OLIMEX/RK3328-SOM-EBV/README.md

# RK3328-SOM-EVB
Evaluation board for RK3328-SOM System on modules

Product page: https://www.olimex.com/Products/SOM/RK3328/RK3328-EVB/

## License
* Hardware is released under CERN OHL v1.2 license
* Software is released under GPL3 License
* Documentation is released under CC BY-SA 3.0
