OLIMEX/RK3328-SOM-EBV/HARDWARE/RK3328-SOM-EVB_Rev-A/3d/TFC-WPAPR-08---112J-TXAR-R_C_1-1.STEP

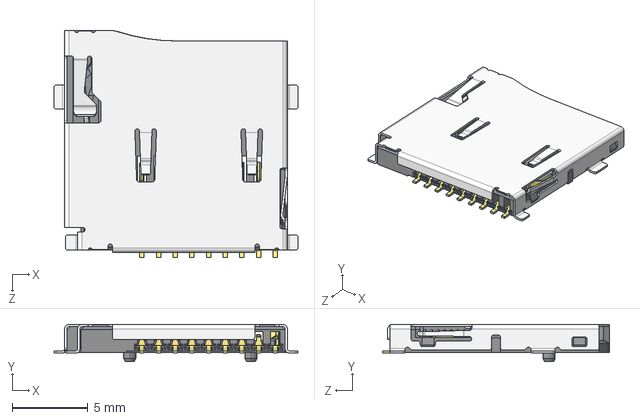
[picture p6: CAD file, 2021-05-31]
HARDWARE/RK3328-SOM-EVB_Rev-A/3d/TFC-WPAPR-08---112J-TXAR-R_C_1-1.STEP
16.1 x 2.45 x 15.0 mm
