OLIMEX/RK3328-SOM-EBV/HARDWARE/RK3328-SOM-EVB_Rev-A/3d/BH26S---CH8726xVA00.STEP

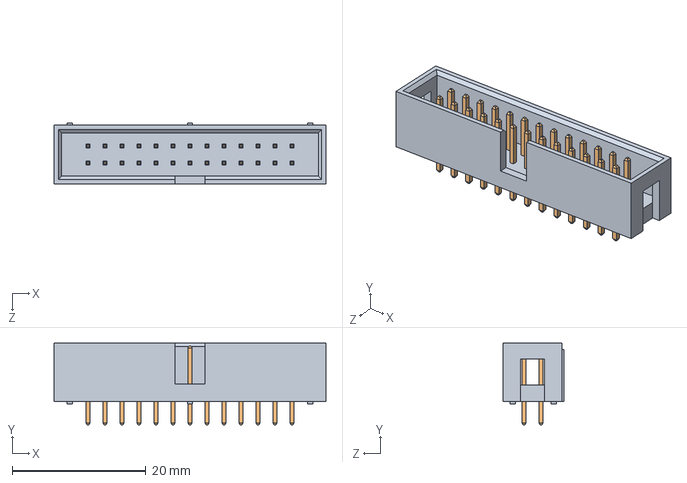
[picture p7: CAD file, 2021-05-31]
HARDWARE/RK3328-SOM-EVB_Rev-A/3d/BH26S---CH8726xVA00.STEP
40.6 x 12.2 x 9.10 mm
CH87 BASE_26
CH87 V PIN x 26
