OLIMEX/RK3328-SOM-EBV/HARDWARE/RK3328-SOM-EVB_Rev-A/3d/USB-A-S-F-B-VU.stp

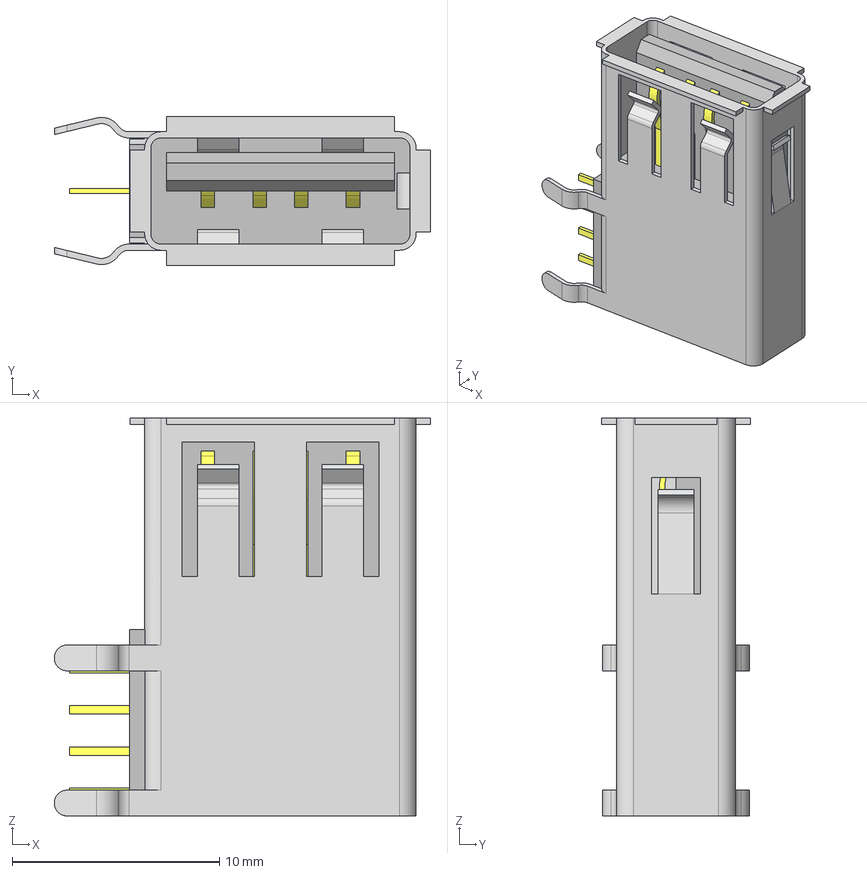
[picture p8: CAD file, 2021-05-31]
HARDWARE/RK3328-SOM-EVB_Rev-A/3d/USB-A-S-F-B-VU.stp
18.2 x 7.20 x 19.2 mm
_USB-A-S-VU_S
_USB-A-S-B-VU_B
_USB-A-S-VU_P
