OLIMEX/RK3328-SOM-EBV/HARDWARE/RK3328-SOM-EVB_Rev-A/3d/40PinMaleSMD.stp

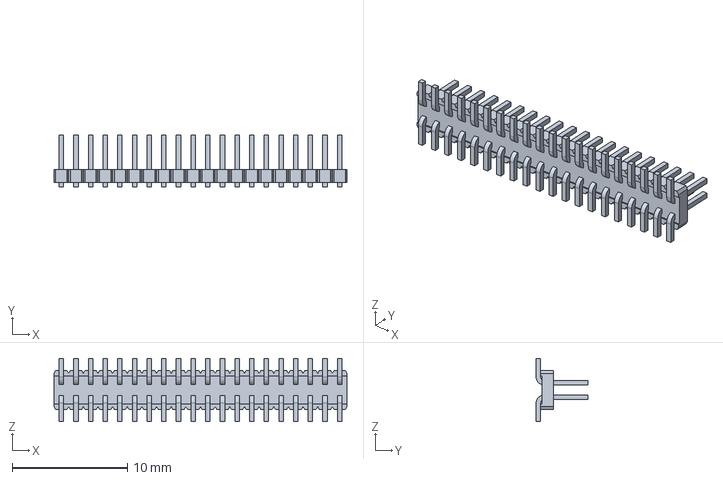
[picture p9: CAD file, 2021-05-31]
HARDWARE/RK3328-SOM-EVB_Rev-A/3d/40PinMaleSMD.stp
25.4 x 4.50 x 5.50 mm
