OLIMEX/RK3328-SOM-EBV/HARDWARE/RK3328-SOM-EVB_Rev-A/3d/pj-102ah.stp

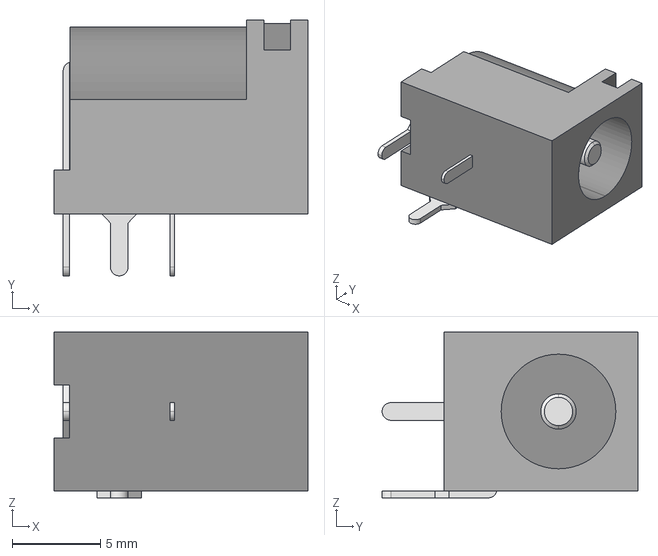
[picture p10: CAD file, 2021-05-31]
HARDWARE/RK3328-SOM-EVB_Rev-A/3d/pj-102ah.stp
14.4 x 14.5 x 9.40 mm
