OLIMEX/RK3328-SOM-EBV/HARDWARE/RK3328-SOM-EVB_Rev-A/3d/DO-214AA_SMB.step

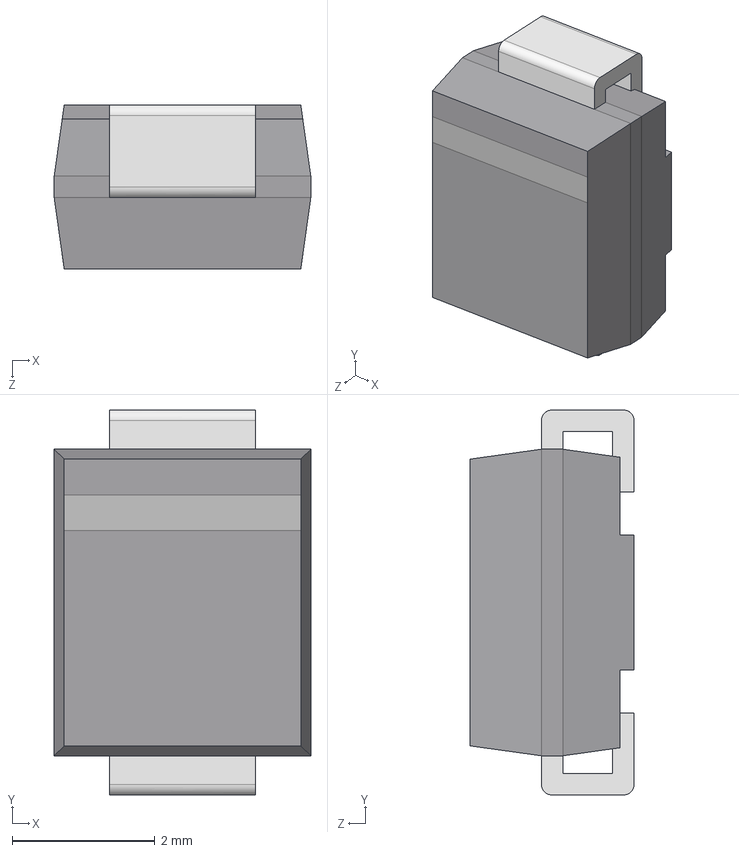
[picture p11: CAD file, 2021-05-31]
HARDWARE/RK3328-SOM-EVB_Rev-A/3d/DO-214AA_SMB.step
3.60 x 5.40 x 2.30 mm
