OLIMEX/RK3328-SOM-EBV/HARDWARE/RK3328-SOM-EVB_Rev-A/3d/HN1x3-PinHeader_1x03_P2.54mm_Vertical.step

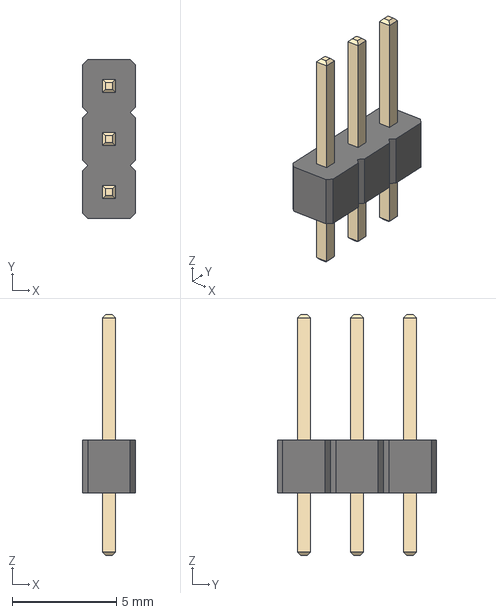
[picture p12: CAD file, 2021-05-31]
HARDWARE/RK3328-SOM-EVB_Rev-A/3d/HN1x3-PinHeader_1x03_P2.54mm_Vertical.step
2.54 x 7.62 x 11.5 mm
