OLIMEX/RK3328-SOM-EBV/HARDWARE/RK3328-SOM-EVB_Rev-A/3d/Connector_1Port_RJ45_Magjack_10-100Base-T_AutoMDIX_Wurth_Electronics-7499010441.stp

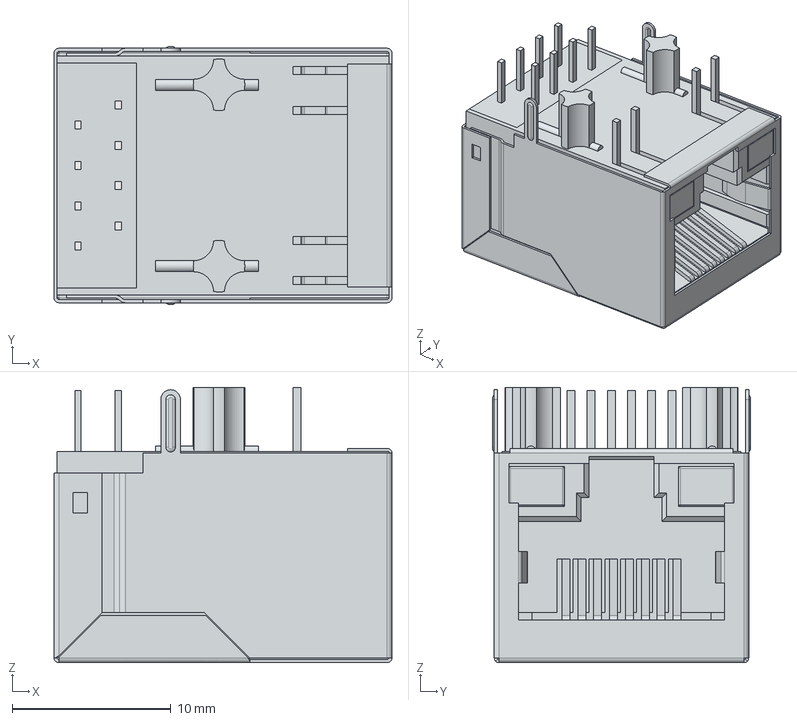
[picture p14: CAD file, 2021-05-31]
HARDWARE/RK3328-SOM-EVB_Rev-A/3d/Connector_1Port_RJ45_Magjack_10-100Base-T_AutoMDIX_Wurth_Electronics-7499010441.stp
21.3 x 16.2 x 17.4 mm
Shielding
Insulator 3
Insulator 1
Insulator 2
Green_Yellow_LED x 2
