OLIMEX/RK3328-SOM-EBV/HARDWARE/RK3328-SOM-EVB_Rev-A/3d/usb_micro_4p.stp

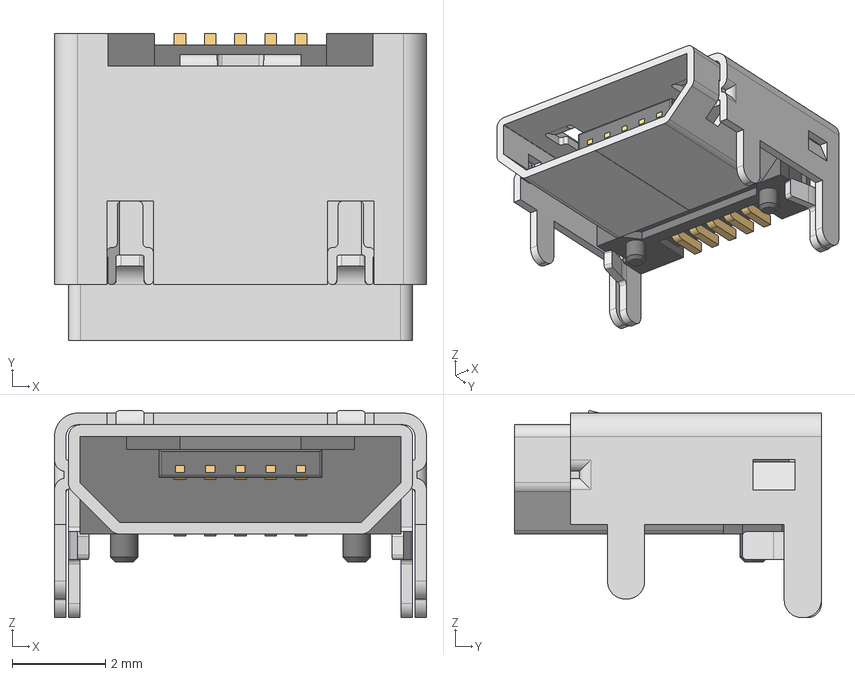
[picture p15: CAD file, 2021-05-31]
HARDWARE/RK3328-SOM-EVB_Rev-A/3d/usb_micro_4p.stp
8.00 x 6.60 x 4.46 mm
