OLIMEX/RK3328-SOM-EBV/HARDWARE/RK3328-SOM-EVB_Rev-A/3d/BH-10__64.step

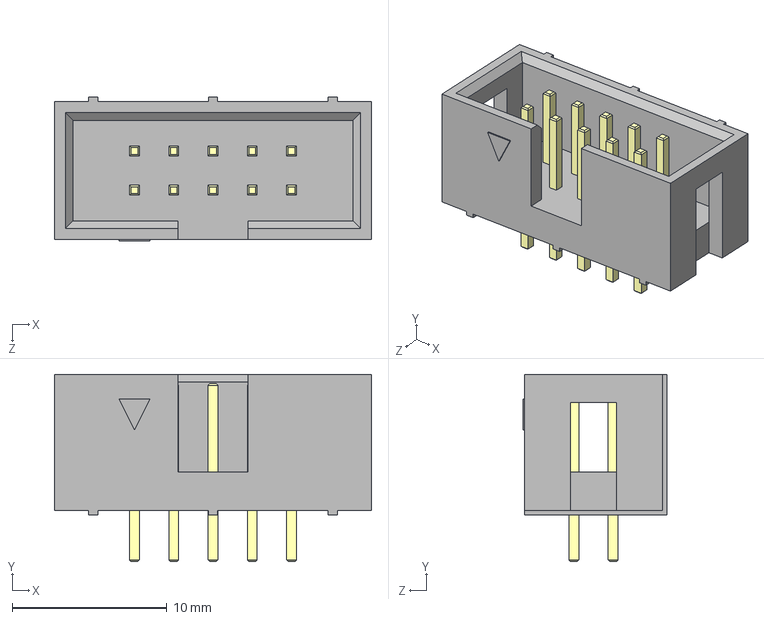
[picture p16: CAD file, 2021-05-31]
HARDWARE/RK3328-SOM-EVB_Rev-A/3d/BH-10__64.step
20.5 x 12.1 x 9.30 mm
