OLIMEX/RK3328-SOM-EBV/HARDWARE/RK3328-SOM-EVB_Rev-A/3d/SOT-23-5.step

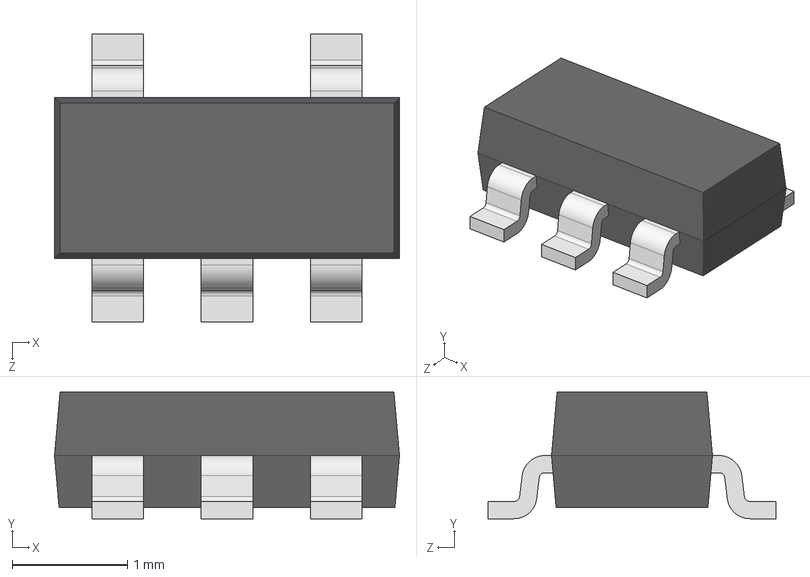
[picture p17: CAD file, 2021-05-31]
HARDWARE/RK3328-SOM-EVB_Rev-A/3d/SOT-23-5.step
3.00 x 1.10 x 2.50 mm
