OLIMEX/RK3328-SOM-EBV/HARDWARE/RK3328-SOM-EVB_Rev-A/3d/SOT-223-2.STEP

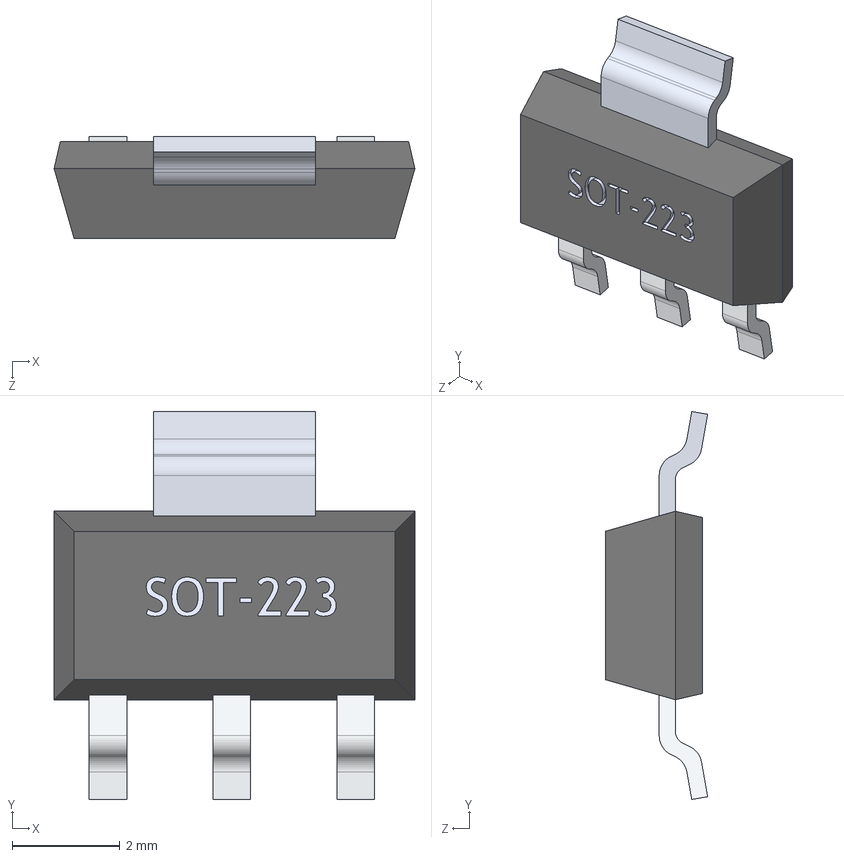
[picture p18: CAD file, 2021-05-31]
HARDWARE/RK3328-SOM-EVB_Rev-A/3d/SOT-223-2.STEP
6.70 x 7.20 x 1.90 mm
User Library-SOT-223-2_PIN_SOT-223_2_1 x 3
User Library-SOT-223-2_SOT-223_1
User Library-SOT-223-2_PIN_SOT-223_1
