OLIMEX/RK3328-SOM-EBV/HARDWARE/RK3328-SOM-EVB_Rev-A/3d/20PinMaleSmt.stp

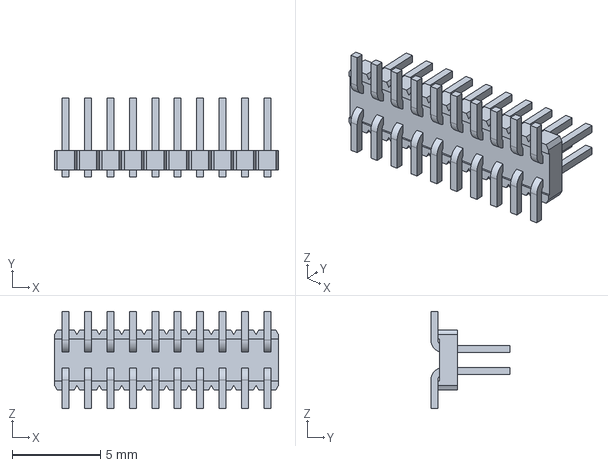
[picture p19: CAD file, 2021-05-31]
HARDWARE/RK3328-SOM-EVB_Rev-A/3d/20PinMaleSmt.stp
12.7 x 4.50 x 5.50 mm
