OLIMEX/RK3328-SOM-EBV/HARDWARE/RK3328-SOM-EVB_Rev-A/3d/USB3.0-TypeA_SWZ1BL-9A.stp

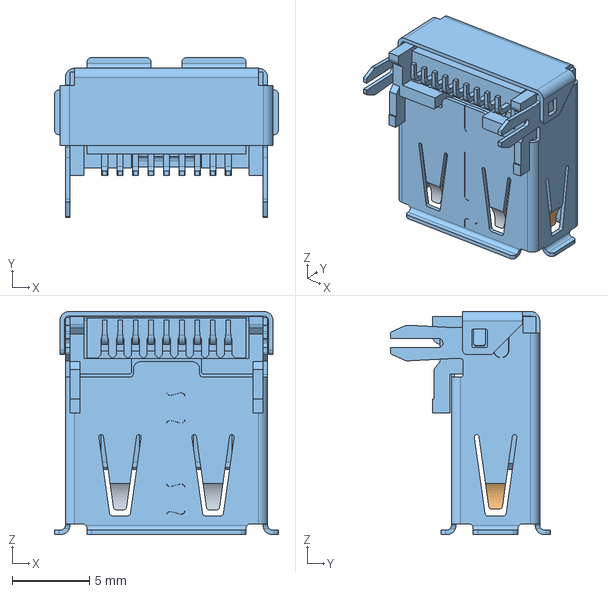
[picture p20: CAD file, 2021-05-31]
HARDWARE/RK3328-SOM-EVB_Rev-A/3d/USB3.0-TypeA_SWZ1BL-9A.stp
14.5 x 10.3 x 14.4 mm
