OLIMEX/RK3328-SOM-EBV/HARDWARE/RK3328-SOM-EVB_Rev-A/3d/QFN48-0.5.STEP

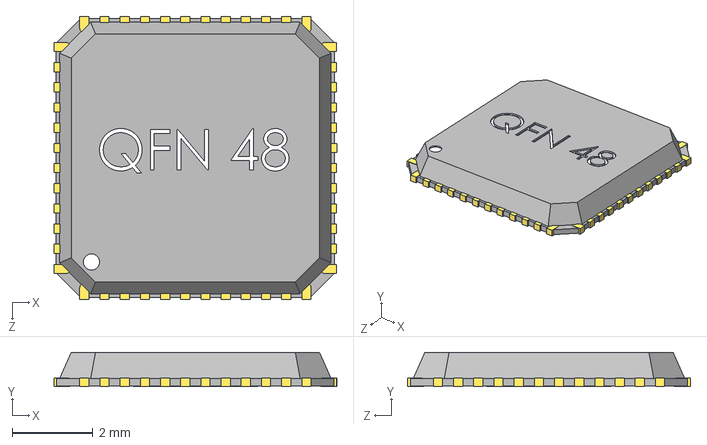
[picture p22: CAD file, 2021-05-31]
HARDWARE/RK3328-SOM-EVB_Rev-A/3d/QFN48-0.5.STEP
7.00 x 0.85 x 7.01 mm
User Library-QFN48-1_Body
User Library-QFN48-1_Pins
