OLIMEX/RK3328-SOM-EBV/HARDWARE/RK3328-SOM-EVB_Rev-A/3d/DO-214AC_SMA.step

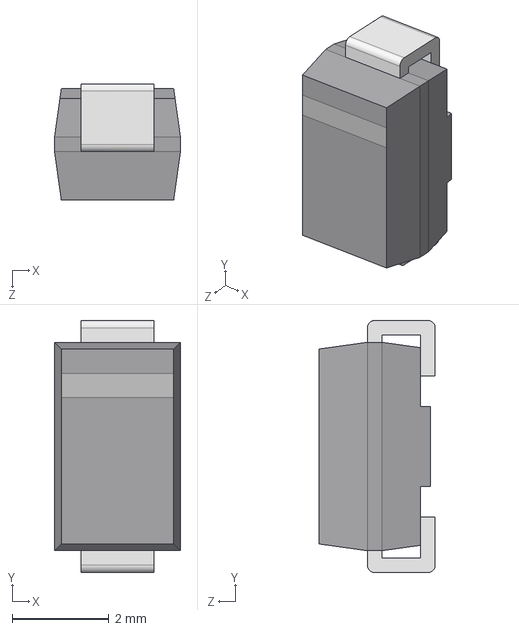
[picture p23: CAD file, 2021-05-31]
HARDWARE/RK3328-SOM-EVB_Rev-A/3d/DO-214AC_SMA.step
2.60 x 5.20 x 2.40 mm
