OLIMEX/RK3328-SOM-EBV/HARDWARE/RK3328-SOM-EVB_Rev-A/3d/SMD075F.step

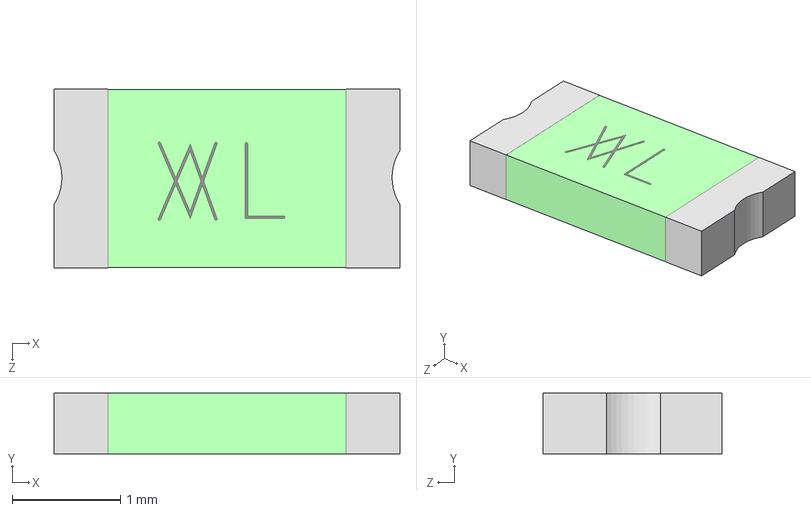
[picture p24: CAD file, 2021-05-31]
HARDWARE/RK3328-SOM-EVB_Rev-A/3d/SMD075F.step
3.20 x 0.562 x 1.65 mm
