OLIMEX/RK3328-SOM-EBV/HARDWARE/RK3328-SOM-EVB_Rev-A/3d/HDMI_19POS_SMD_Wurth_Electronic-685119134923.stp

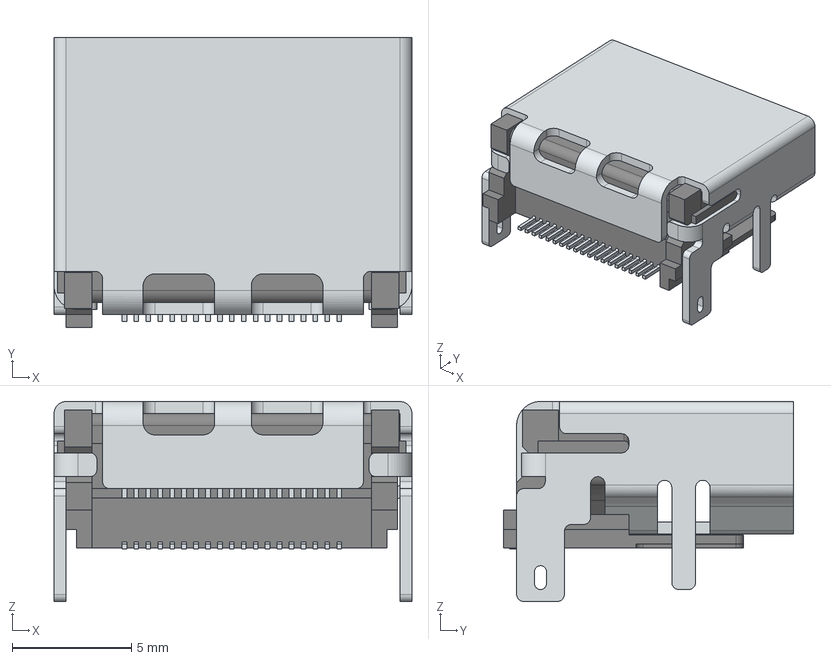
[picture p25: CAD file, 2021-05-31]
HARDWARE/RK3328-SOM-EVB_Rev-A/3d/HDMI_19POS_SMD_Wurth_Electronic-685119134923.stp
15.0 x 12.2 x 8.38 mm
