OLIMEX/RK3328-SOM-EBV/HARDWARE/RK3328-SOM-EVB_Rev-A/3d/DF12(3.0)-40DS-0.5V.stp

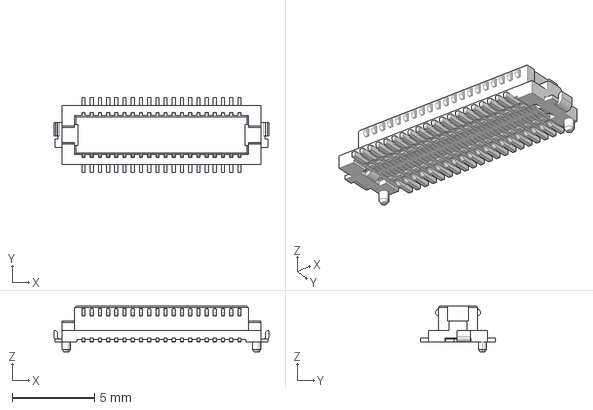
[picture p27: CAD file, 2021-05-31]
HARDWARE/RK3328-SOM-EVB_Rev-A/3d/DF12(3.0)-40DS-0.5V.stp
13.1 x 4.60 x 2.80 mm
