OLIMEX/RK3328-SOM-EBV/(list of files, cad)

Other CAD files:
HARDWARE/RK3328-SOM-EVB_Rev-A/3d/434121043836 (rev1).stp
HARDWARE/RK3328-SOM-EVB_Rev-A/3d/Connector_1Port_RJ45_Magjack_10-100Base-T_AutoMDIX_Molex-0934635206_DigiKey-WM17614-ND.stp
