OLIMEX/RK3328-SOM-EBV/HARDWARE/RK3328-SOM-EVB_Rev-A/RK3328-SOM-EVB_Rev_A.pdf

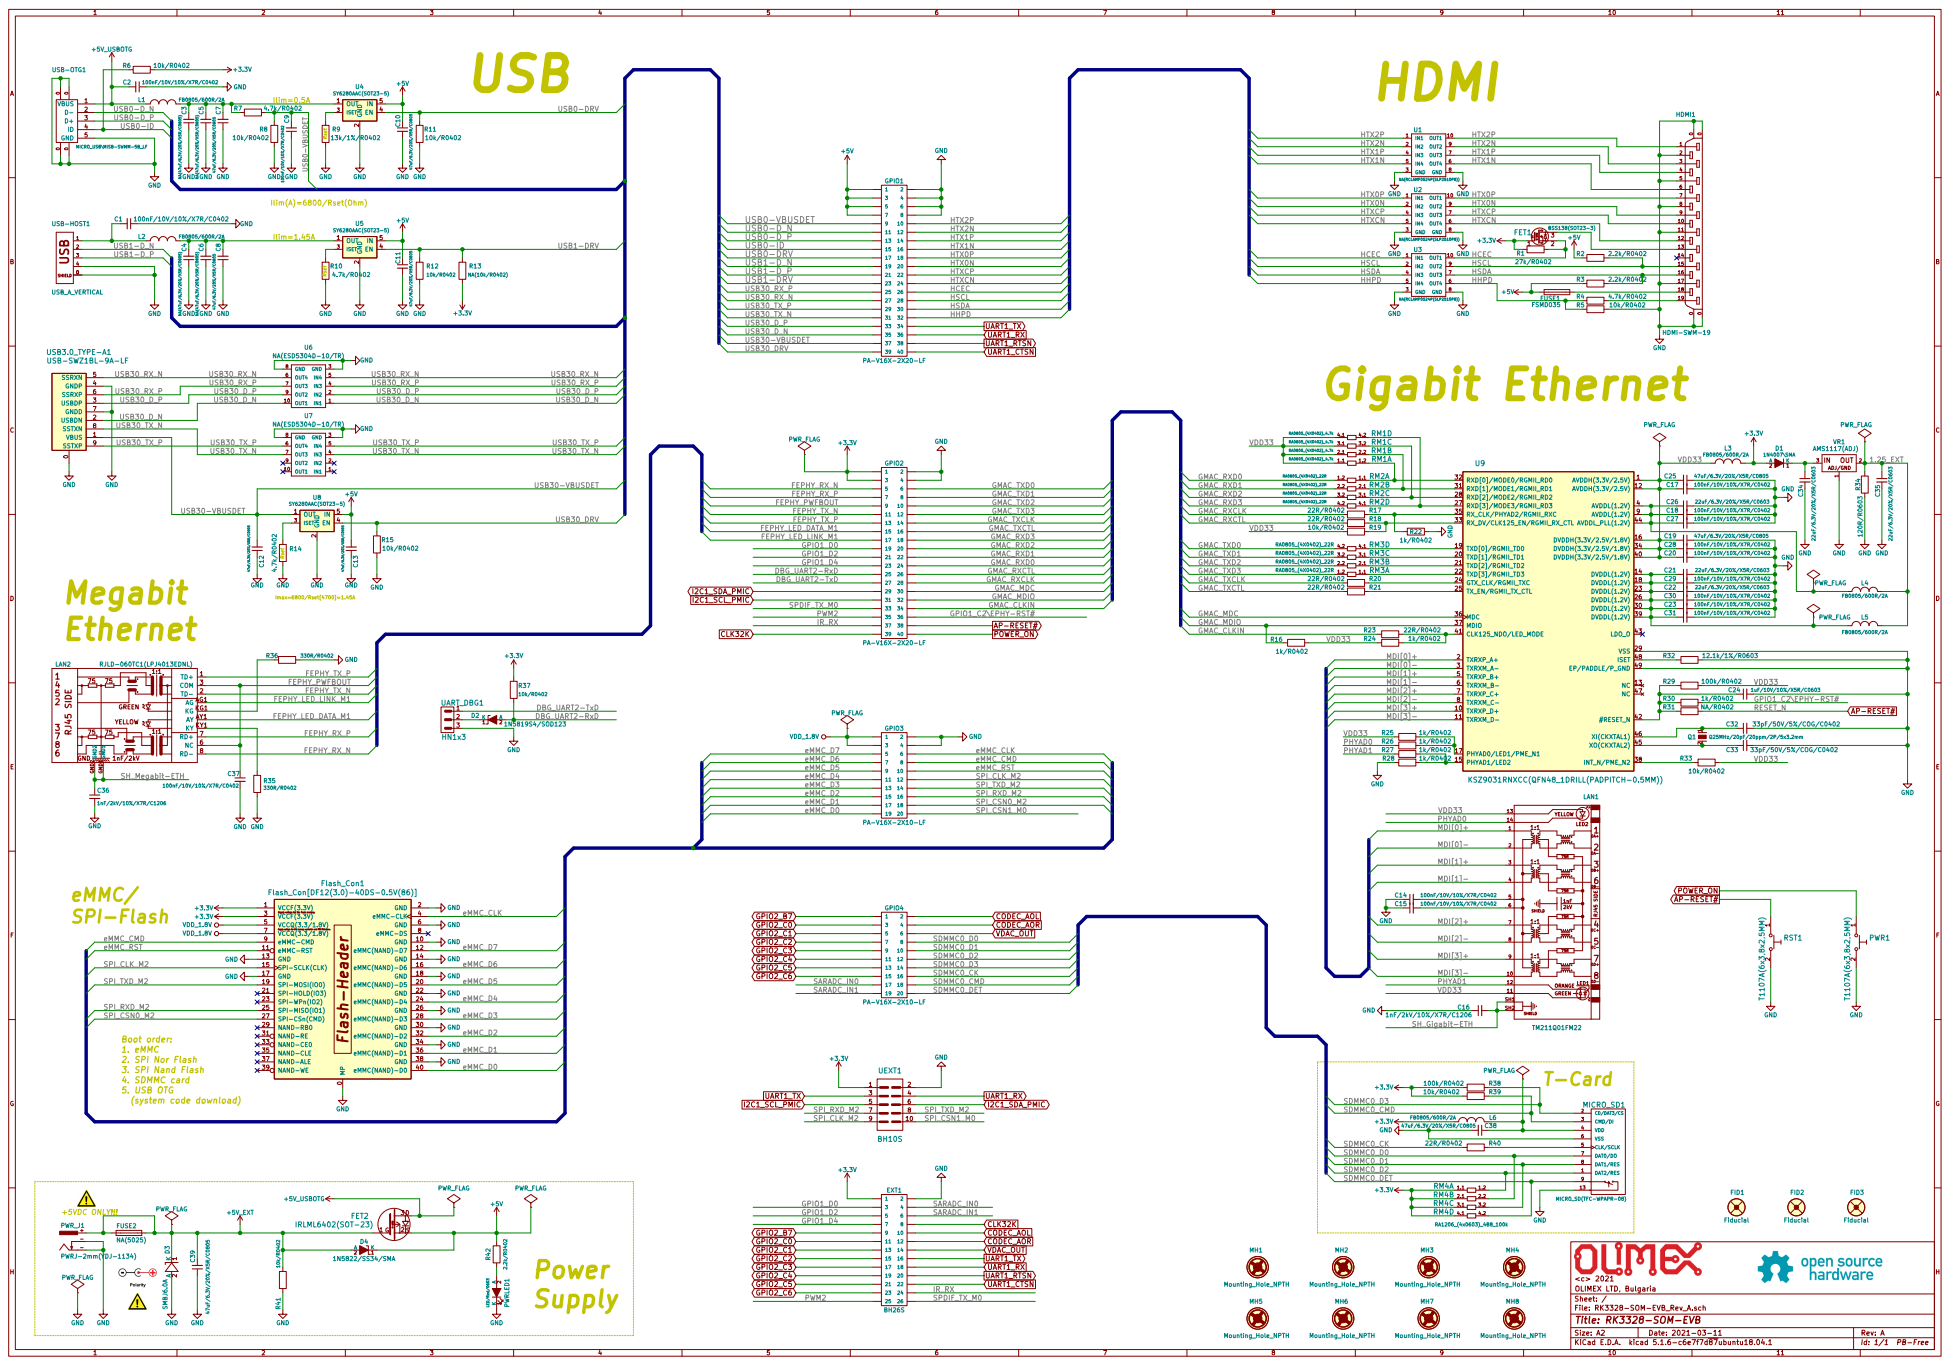
[picture p28: page 1]

Ilim(A)=6800/Rset(Ohm) Megabit

GND C8 47uF/6.3V/20%/X5R/C0805 GND GND GND

0 VBUS 1 USBDN 2 USBDP 3 GNDP 4 SSRXN 5 SSRXP 6 GNDD 7 SSTXN 8 SSTXP 9 USB3.0_TYPE-A1 USB-SWZ1BL-9A-LF

AP-RESET#
DA+ DA- DB+ DB- DC+ DC- DD+ DD- GREEN

(system code download) eMMC/
SPI-Flash

Boot order: 1. eMMC 2. SPI Nor Flash 3. SPI Nand Flash

File: RK3328-SOM-EVB_Rev_A.sch Sheet: / OLIMEX LTD, Bulgaria <c> 2021

Id: 1/1 PB-Free Title: RK3328-SOM-EVB
