OLIMEX/RK3328-SOM-EBV/(notices)

Notices in the files:
HARDWARE/RK3328-SOM-EVB_Rev-A/3d/HN1x3-PinHeader_1x03_P2.54mm_Vertical.step:
Copyright (C) 2017, kicad StepUp
This work is licensed under the [Creative Commons CC-BY-SA 4.0 License](https://creativecommons.org/licenses/by-sa/4.0/legalcode),
with the following exception:
To the extent that the creation of electronic designs that use 'Licensed Material' can be considered to be 'Adapted Material',
You are free to use the library data in your own projects without the obligation to share your project files under this or any other license agreement.
